ExploreEmbedded/Explore-Time-DIY-11003/Others/Specification.xlsx

Id | Designator | Package | Quantity | Designation | Supplier and ref
1 | P1 | VASCH5x2 | 1 | CONN_5X2 | 3
2 | RV1 | RV2 | 1 | POT | 4
3 | R4 | R4 | 1 | 2.2K | 0.5
4 | R3,R2,R1 | R4 | 3 | 10K | 1.5
5 | U1 | DIP-8__300_ELL | 1 | DS1307 | 2
6 | IC1 | DIP-28__300_ELL | 1 | ATMEGA8-P | 4
7 | X1 | C1 | 1 | CRYSTAL | 3
8 | C2,C1 | C1 | 2 | 0.1uF | 1
9 | BT1 | BATT_rtc_XL | 1 | BATTERY | 4
10 | LCD1 | lcd_2x16_led_backlight-HY-1602F | 1 | LCD_2X16_SIL | 1
11 | SW3 | SW_PUSH_SMALL | 1 | DEC | 5
12 | SW5 | SW_PUSH_SMALL | 1 | CAN | 5
13 | SW2 | SW_PUSH_SMALL | 1 | INC | 5
14 | SW4 | SW_PUSH_SMALL | 1 | SEL | 5
15 | SW1 | SW_PUSH_SMALL | 1 | SPST | 5
16 | P2 | bornier2 | 1 | Power | 3
17 | P3,P4,P5,P6,P7,P8,P9,P10 | 1pin | 8 | CONN_1 | 1
18 | SP1 | BUZ3-5 | 1 | SPEAKER | 7
19 | P12,P11 | SIL-4 | 2 | CONN_4 | 1
20 | R5 | R4 | 1 | 470 | 0.5
21 | D1 | LED-3MM | 1 | 5MM | 1
22 | C3 | C1V5 | 1 | 100uF, 25V | 2
23 | K1 | BARREL_JACK | 1 | BARREL | 3
24 | U2 | LM78XXV | 1 | 7805 | 5
 |  |  |  | Total | 72.5
 | Pricing
 |  | Component | 72
 |  | PCB | 55
 |  | Solder | 20
 |  | Line Total | 147
 |  | vat | 5
 |  | Markup | 3
 | Selling Price | Total | 456 | 450
 | In Stock |  |  | ?
 | Diemensions |  | 10.5X6.5 | ?
 | Schematic PDF |  |  | ?
