ExploreEmbedded/Explore-Time-DIY-11003/Hardware/DIY_CLOCK.pdf

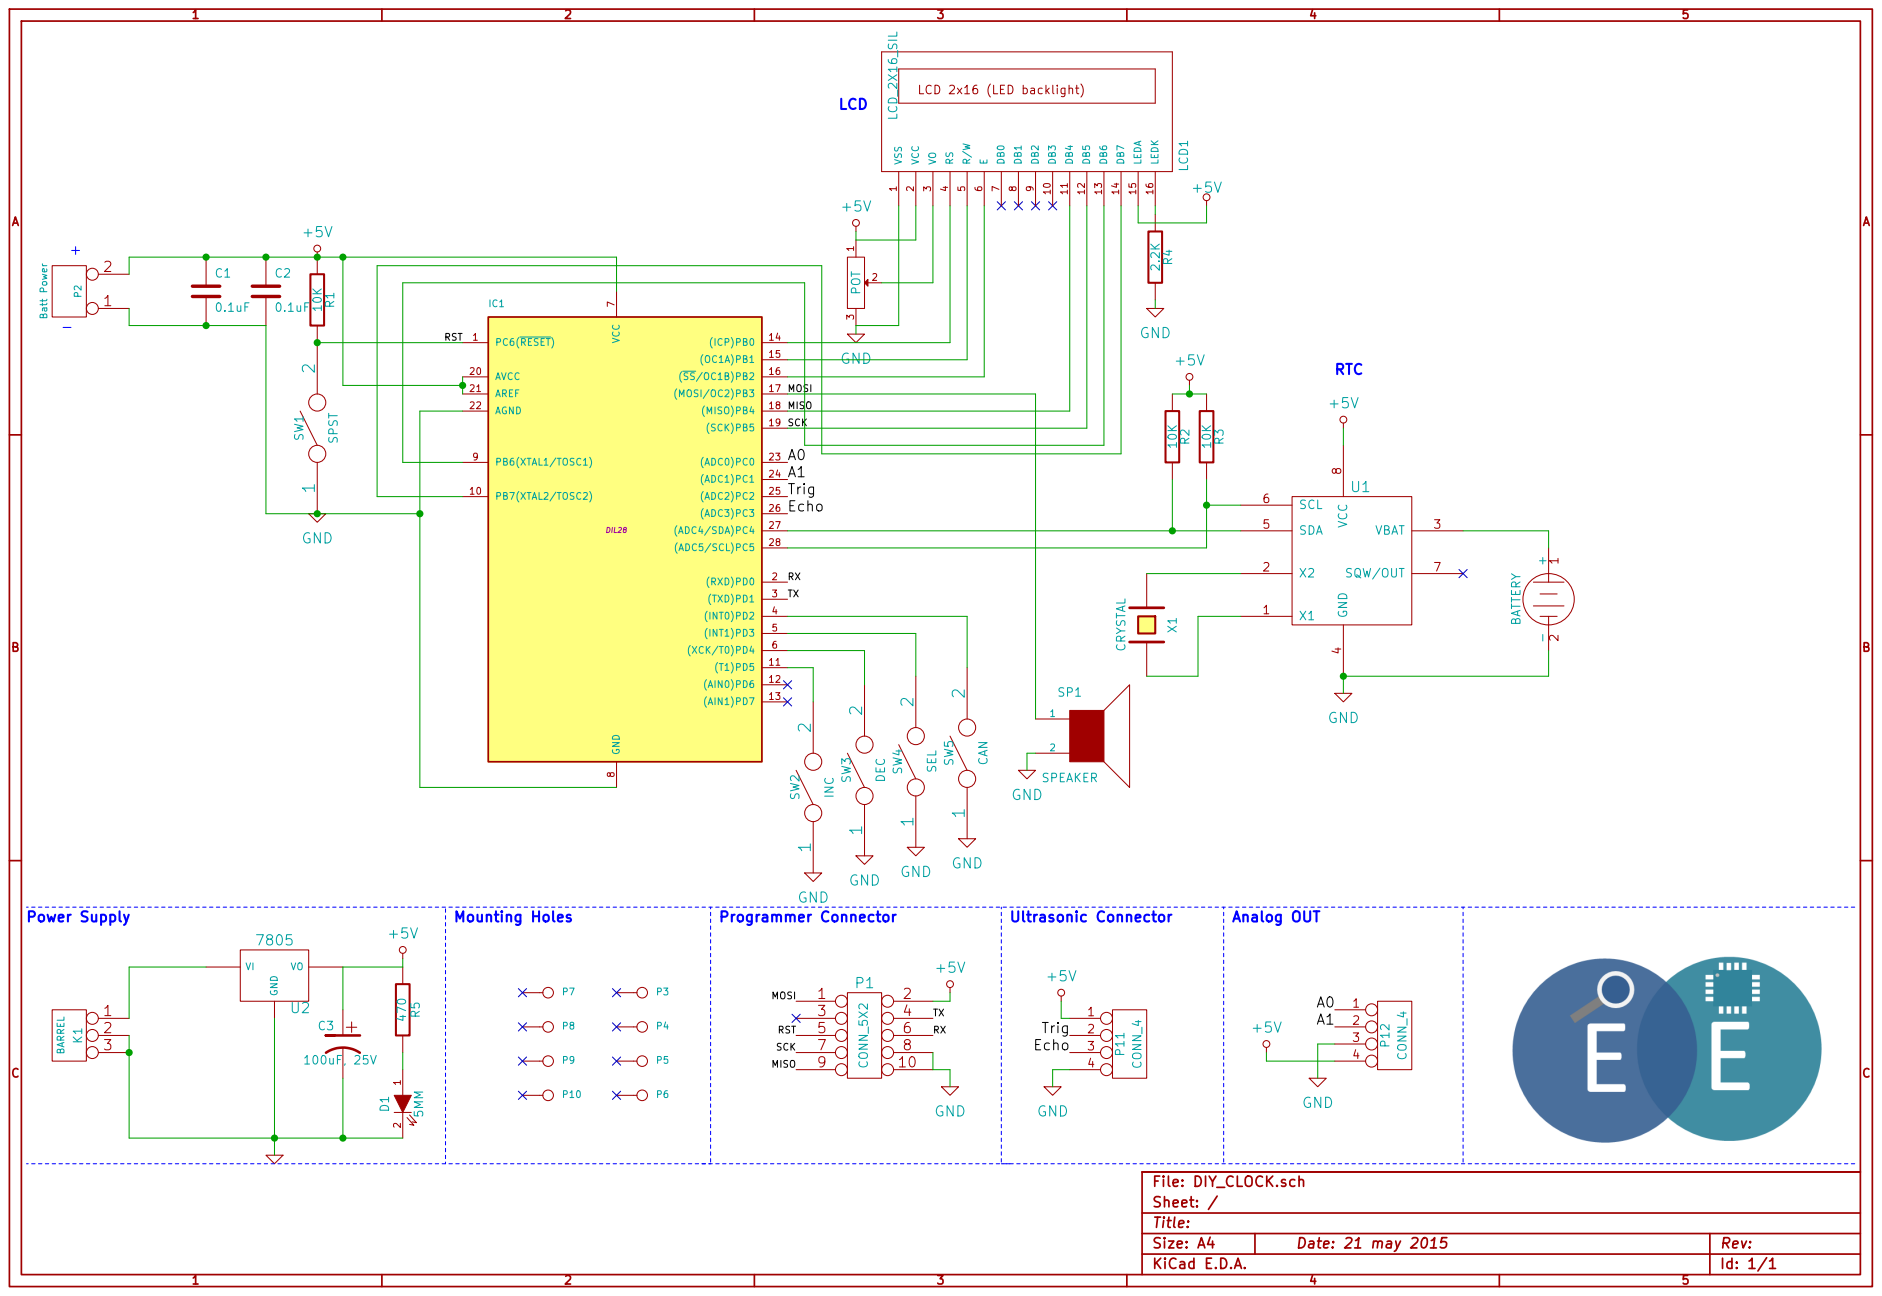
[picture p1: page 1]

Id: 1/1 Title: File: DIY_CLOCK.sch
Sheet: /
