ExploreEmbedded/Explore-Time-DIY-11003/(list of files, drawings)

Other design files:
Hardware/DIY_CLOCK.dsn
