ExploreEmbedded/Explore-Time-DIY-11003/Hardware/DIY_CLOCK.kicad_pcb

## KiCad design Hardware/DIY_CLOCK.kicad_pcb (2015-05-21)

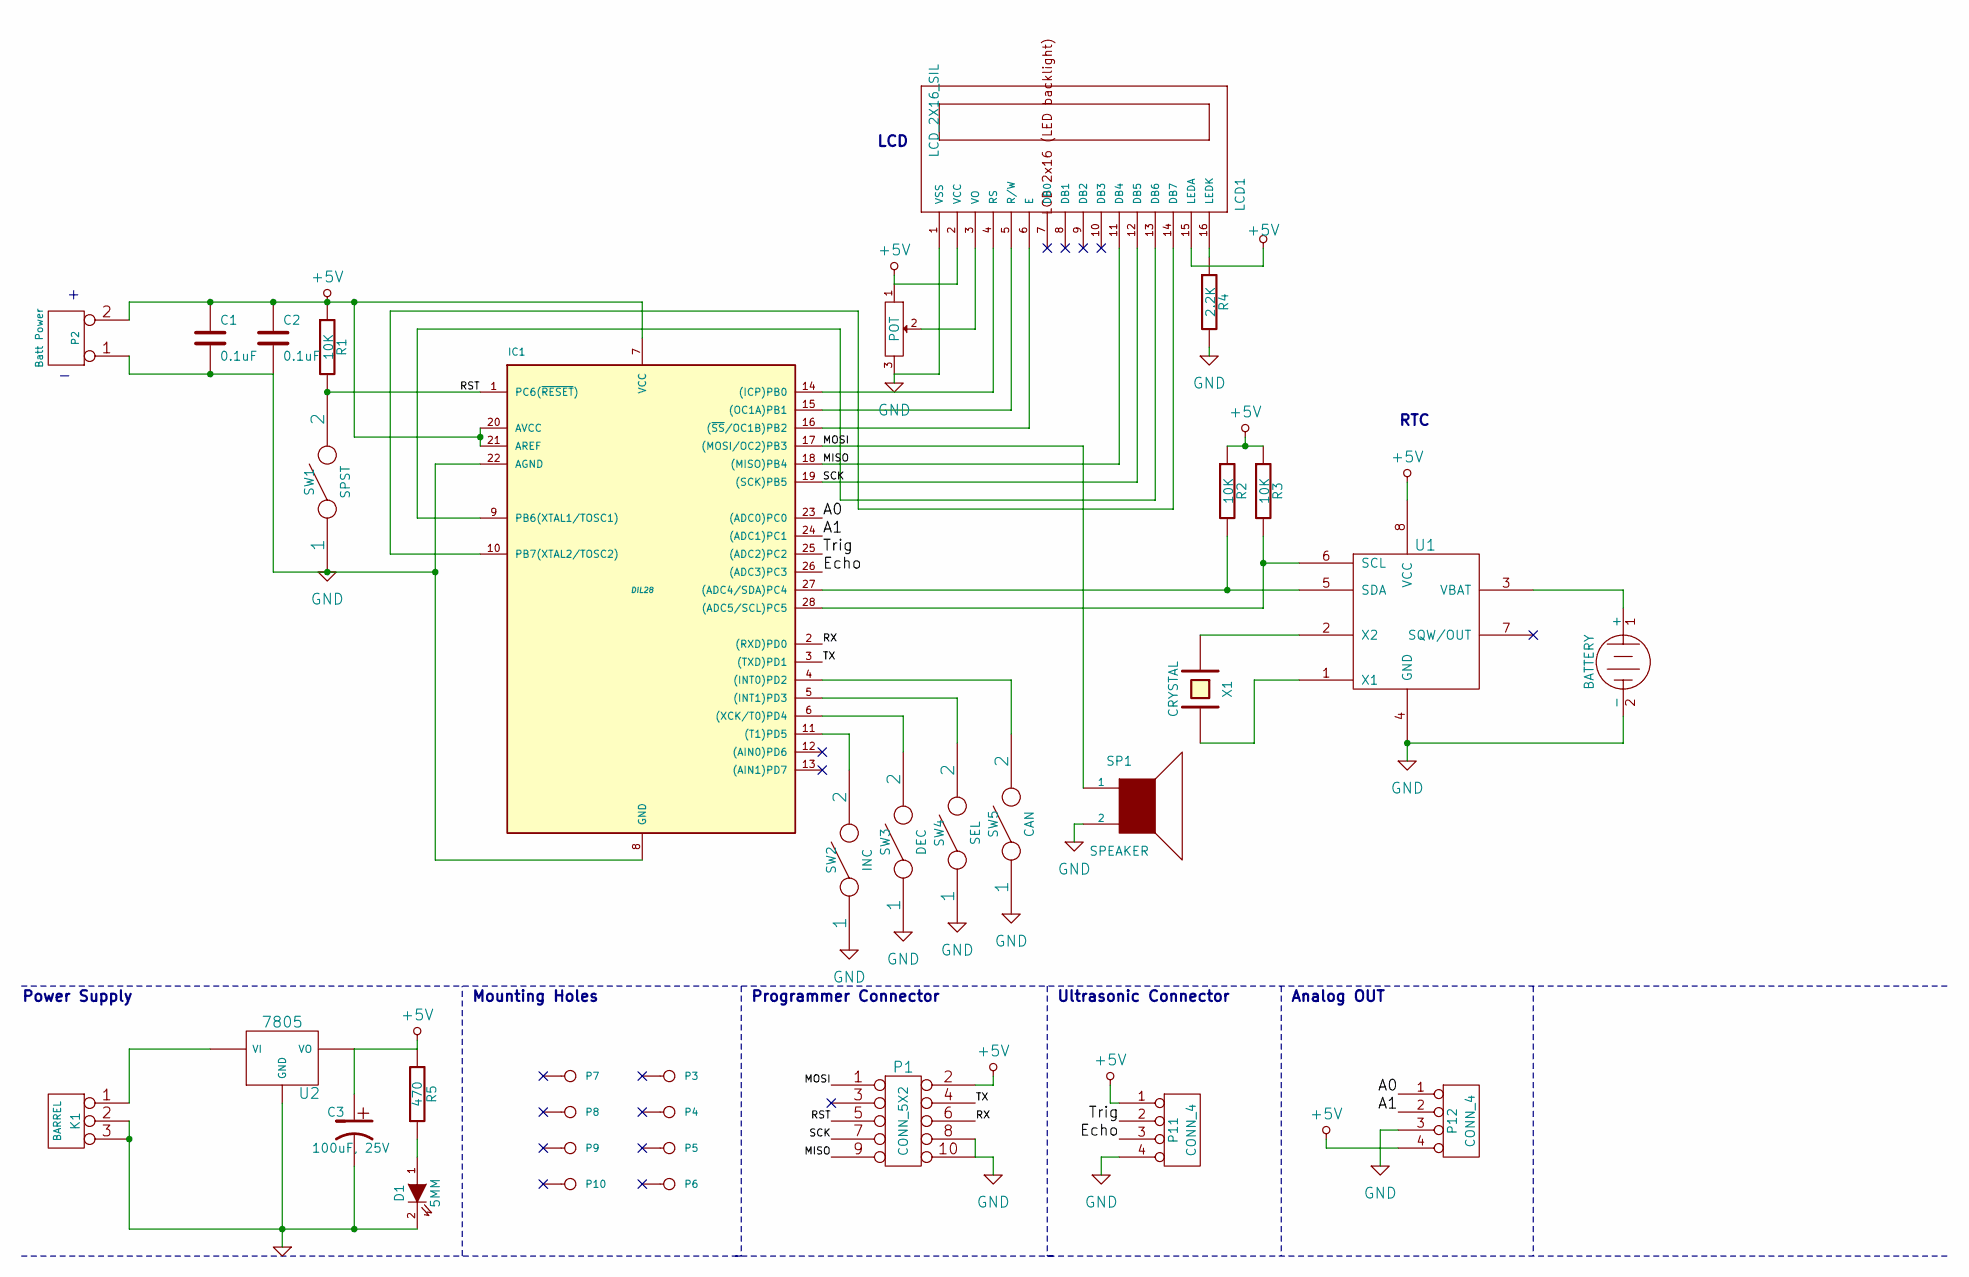
[picture p2: schematic DIY_CLOCK.sch]

Parts:
BT1: BATTERY
C1, C2: 0.1uF
C3: 100uF, 25V
D1: 5MM
IC1: ATMEGA8-P; DIL28
K1: BARREL
LCD1: LCD_2X16_SIL; lcd_2x16_led_backlight-HY-1602F
P1: CONN_5X2
P2: Batt Power
P3, P4, P5, P6, P7, P8, P9, P10: CONN_1
P11, P12: CONN_4
R1, R2, R3: 10K
R4: 2.2K
R5: 470
RV1: POT
SP1: SPEAKER
SW1: SPST
SW2: INC
SW3: DEC
SW4: SEL
SW5: CAN
U1: DS1307
U2: 7805
X1: CRYSTAL

Connections:
+5V: C1.1, C2.1, C3.1, IC1.7 (VCC), IC1.20 (AVCC), IC1.21 (AREF), LCD1.2 (VCC), LCD1.15 (LEDA), P1.2, P2.2 (PM), P11.1, P12.4, R1.1, R2.1, R3.1, R5.2, RV1.1, U1.8 (VCC), U2.VO
/A0: IC1.23 ((ADC0)PC0), P12.1
/A1: IC1.24 ((ADC1)PC1), P12.2
/Echo: IC1.26 ((ADC3)PC3), P11.3
/MISO: IC1.18 ((MISO)PB4), LCD1.11 (DB4), P1.9
/MOSI: IC1.17 ((MOSI/OC2)PB3), P1.1, SP1.1
/RST: IC1.1 (PC6(~RESET~)), P1.5, R1.2, SW1.2
/RX: IC1.2 ((RXD)PD0), P1.6
/SCK: IC1.19 ((SCK)PB5), LCD1.12 (DB5), P1.7
/TX: IC1.3 ((TXD)PD1), P1.4
/Trig: IC1.25 ((ADC2)PC2), P11.2
GND: BT1.2 (-), C1.2, C2.2, C3.2, D1.2 (K), IC1.8 (GND), IC1.22 (AGND), K1.2 (PM), K1.3, LCD1.1 (VSS), P1.8, P1.10, P2.1, P11.4, P12.3, R4.2, RV1.3, SP1.2, SW1.1, SW2.1, SW3.1, SW4.1, SW5.1, U1.4 (GND), U2.GND
unnamed: IC1.6 ((XCK/T0)PD4), SW3.2
unnamed: BT1.1 (+), U1.3 (VBAT)
unnamed: U1.1 (X1), X1.2
unnamed: IC1.11 ((T1)PD5), SW2.2
unnamed: IC1.5 ((INT1)PD3), SW4.2
unnamed: IC1.4 ((INT0)PD2), SW5.2
unnamed: IC1.28 ((ADC5/SCL)PC5), R3.2, U1.6 (SCL)
unnamed: IC1.27 ((ADC4/SDA)PC4), R2.2, U1.5 (SDA)
unnamed: LCD1.3 (VO), RV1.2
unnamed: IC1.10 (PB7(XTAL2/TOSC2)), LCD1.14 (DB7)
unnamed: U1.2 (X2), X1.1
unnamed: IC1.9 (PB6(XTAL1/TOSC1)), LCD1.13 (DB6)
unnamed: K1.1, U2.VI
unnamed: D1.1 (A), R5.1
unnamed: LCD1.16 (LEDK), R4.1
unnamed: IC1.14 ((ICP)PB0), LCD1.4 (RS)
unnamed: IC1.16 ((~SS~/OC1B)PB2), LCD1.6 (E)
unnamed: IC1.15 ((OC1A)PB1), LCD1.5 (R/W)

Notes on the sheet:
Power Supply
Mounting Holes
Programmer Connector
Ultrasonic Connector
Analog OUT
RTC
LCD

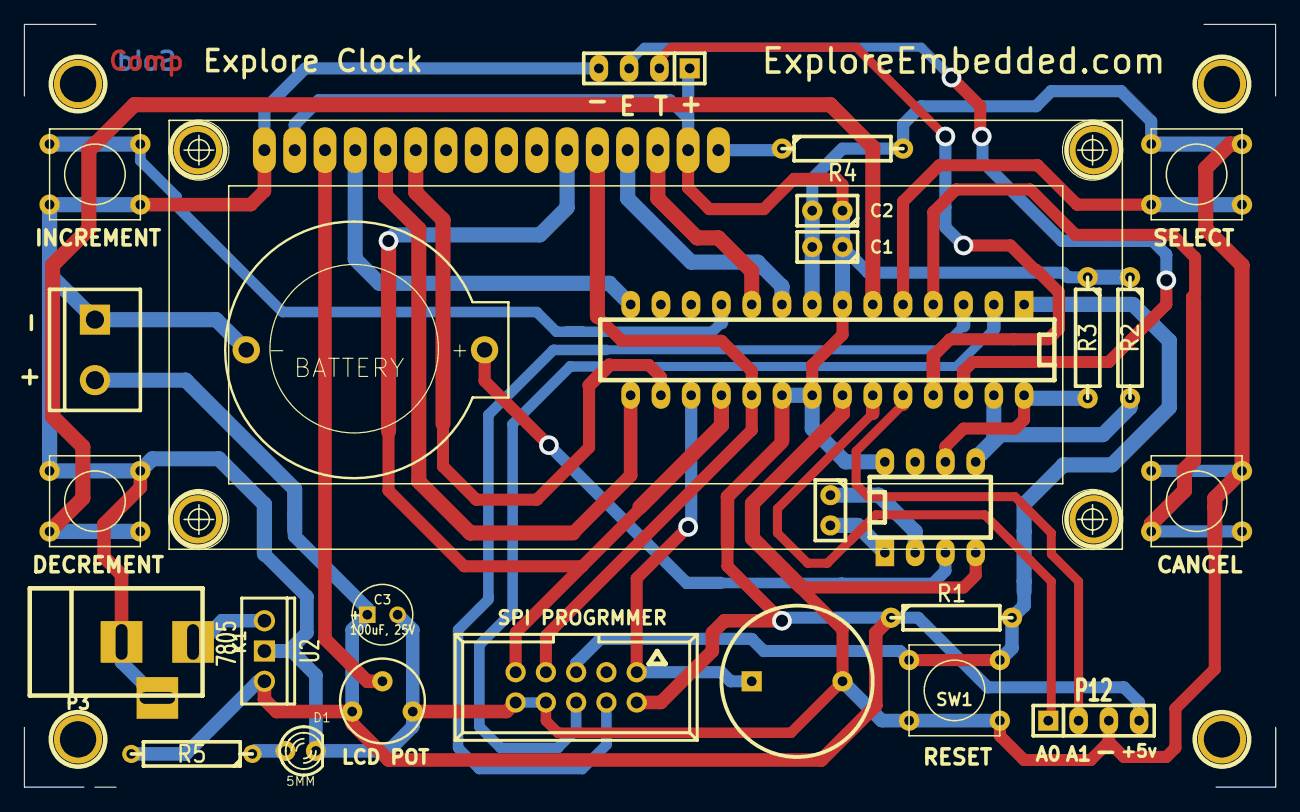
[picture p3: board DIY_CLOCK.kicad_pcb from above]

Board: 2 copper layers, 105.0 x 64.0 mm, 35 parts (0 on the bottom side), 30 nets.
